amartinezacosta/cSTER-Robotic-Arm-PCB/cSTER_Space_Robotic_Arm_Schematic.html

Partlist exported from C:/Users/Alejandro/Documents/EAGLE/projects/cSTER_Space_Robotic_Arm/cSTER_Space_Robotic_Arm_Schematic.sch at 3/8/2022 9:03 AM

Qty | Value | Device | Package | Parts | Description
1 | | 10-XX | B3F-10XX | S1 | OMRON SWITCH
2 | | C-EUC0603 | C0603 | C37, C40 | CAPACITOR, European symbol
5 | | LEDCHIPLED_0805 | CHIPLED_0805 | LED1, LED2, LED3, LED4, LED5 | LED
1 | | R-US_R0603 | R0603 | R23 | RESISTOR, American symbol
3 | 0.01uF | C-EUC0402K | C0402K | C2, C4, C6 | CAPACITOR, European symbol
2 | 0.01uF | C-EUC0805 | C0805 | C21, C24 | CAPACITOR, European symbol
9 | 0.1uF | C-EUC0402K | C0402K | C1, C3, C5, C9, C10, C28, C30, C38, C39 | CAPACITOR, European symbol
5 | 0.1uF | C-EUC0603 | C0603 | C13, C26, C29, C31, C33 | CAPACITOR, European symbol
4 | 0.2 | R-US_R1206 | R1206 | R3, R4, R5, R6 | RESISTOR, American symbol
1 | 0ZCH0075AF2E | 0ZCH0075AF2E | 0ZCH0075AF2E | F1
1 | 1.0uF | C-EUC0402K | C0402K | C8 | CAPACITOR, European symbol
3 | 100 | R-US_R0603 | R0603 | R20, R21, R22 | RESISTOR, American symbol
1 | 10118194-0001LF | 10118194-0001LF | AMPHENOL_10118194-0001LF | J7 | Micro Usb, 2.0 Type b, Rcpt, Smt
1 | 10K | R-US_R0603 | R0603 | R2 | RESISTOR, American symbol
2 | 10k | R-US_R0402 | R0402 | R7, R10 | RESISTOR, American symbol
8 | 10k | R-US_R0603 | R0603 | R9, R14, R15, R16, R17, R18, R19, R24 | RESISTOR, American symbol
1 | 10nF | C-EUC0603 | C0603 | C27 | CAPACITOR, European symbol
2 | 10pF | C-EUC0402K | C0402K | C14, C15 | CAPACITOR, European symbol
2 | 10uF | C-EUC0603 | C0603 | C19, C32 | CAPACITOR, European symbol
2 | 10uF | C-EUC1206 | C1206 | C17, C18 | CAPACITOR, European symbol
2 | 10uF | CPOL-USCT3216 | CT3216 | C20, C23 | POLARIZED CAPACITOR, American symbol
2 | 150 | R-US_R0603 | R0603 | R11, R13 | RESISTOR, American symbol
1 | 1M | R-US_R0402 | R0402 | R1 | RESISTOR, American symbol
1 | 2.2nF | C-EUC0603 | C0603 | C36 | CAPACITOR, European symbol
1 | 2.2uF | C-EUC0402K | C0402K | C7 | CAPACITOR, European symbol
2 | 2.2uF | C-EUC0603 | C0603 | C22, C25 | CAPACITOR, European symbol
3 | 220 | R-US_R0603 | R0603 | R12, R25, R26 | RESISTOR, American symbol
1 | 22k | R-US_R0603 | R0603 | R27 | RESISTOR, American symbol
3 | 22uF | C-EUC1206 | C1206 | C16, C34, C35 | CAPACITOR, European symbol
2 | 24pF | C-EUC0402K | C0402K | C11, C12 | CAPACITOR, European symbol
1 | 3221-10-0300-00 | 3221-10-0300-00 | 3221-10-0300-00 | J1
1 | 65k | R-US_R0603 | R0603 | R8 | RESISTOR, American symbol
4 | B6B-ZR(LF)(SN) | B6B-ZR(LF)(SN) | JST_B6B-ZR(LF)(SN) | J3, J4, J5, J6 | ZR Series 1.5 mm Pitch 6 Position Through Hole Top Entry Shrouded Heade
1 | CDRH104RNP | CDRH104RNP | CDRH104RNP | L1
9 | CPDQC5V0R | CPDQC5V0R | CPDQC5V0R | D1, D2, D3, D4, D5, D6, D7, D8, D9
2 | DRV8833PW | DRV8833PW | SOP65P640X120-16N | U2, U3
1 | ECS-160-9-42-CKM-TR | ECS-160-9-42-CKM-TR | XTAL_ECS-160-9-42-CKM-TR | Y1 | Crystal 4-SMD, No Lead
1 | JS202011CQN | JS202011CQN | JS202011CQN | U$1
1 | MEM2051-00-195-00-A | MEM2051-00-195-00-A | GCT_MEM2051-00-195-00-A | J9 | Connector, Memory Card, Micro Sd, 8 Position, 1.1mm, Full Reel
1 | MF-MSMF050-2 | MF-MSMF050-2 | FUSM4632X85 | F2 | PTC Resettable Fuse 0.5A(hold) 1A(trip) 15V 100A 0.8W 0.15s 0.15Ohm SMD Solder Pad 1812 T/R
1 | PC-104-PLUS | PC-104-PLUS | PC-104-PLUS | J2
1 | ROBOT_PORT | ROBOT_PORT | ROBOT_PORT | J8
1 | RT3215-32.768-12.5-TR | RT3215-32.768-12.5-TR | RT3215-32.768-12.5-TR | Y2
1 | RT8293B | RT8293B | RT8293B | U12
1 | TM4C1233H6PMIR | TM4C1233H6PMIR | PM0064A_N | U1
21 | TPPAD1-13 | TPPAD1-13 | P1-13 | TP1, TP2, TP3, TP4, TP5, TP7, TP8, TP9, TP10, TP11, TP12, TP13, TP14, TP15, TP16, TP17, TP18, TP19, TP20, TP21, TP22 | Test pad
1 | TPS73633DBVR | TPS73633DBVR | SOT95P280X145-5N | U4 | 400-mA, high-accuracy, ultra-low-dropout voltage regulator with reverse current protection and enable 5-SOT-23 -40 to 125
2 | TXB0102DCURG4 | TXB0102DCURG4 | SOP50P310X90-8N | U5, U6 | 2-Bit Bidirectional Voltage-Level Shifter with Auto Direction Sensing and +/-15-kV ESD Protect 8-VSSOP -40 to 85
