amartinezacosta/cSTER-Robotic-Arm-PCB/cSTER_Space_Robotic_Arm_bottom.png

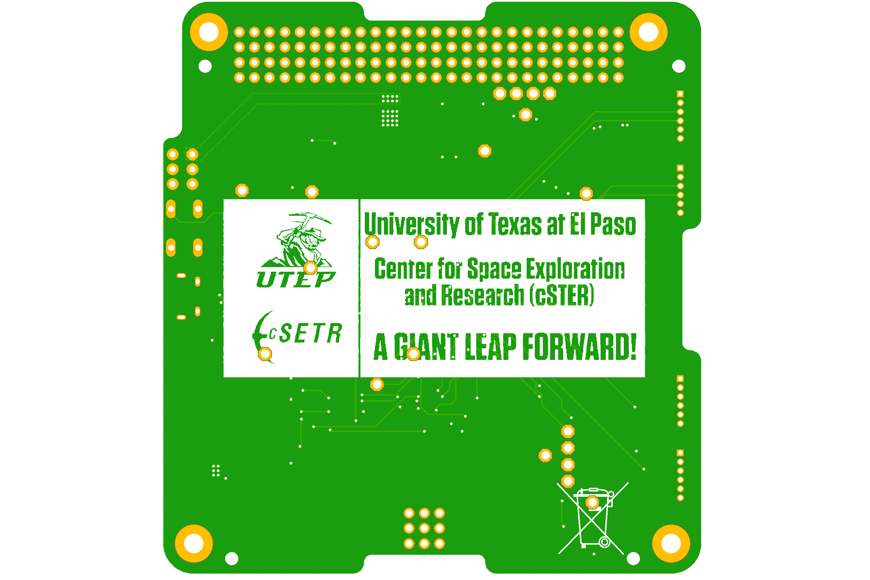
cSTER_Space_Robotic_Arm_bottom.png
