amartinezacosta/cSTER-Robotic-Arm-PCB/cSTER_Space_Robotic_Arm_Schematic.png

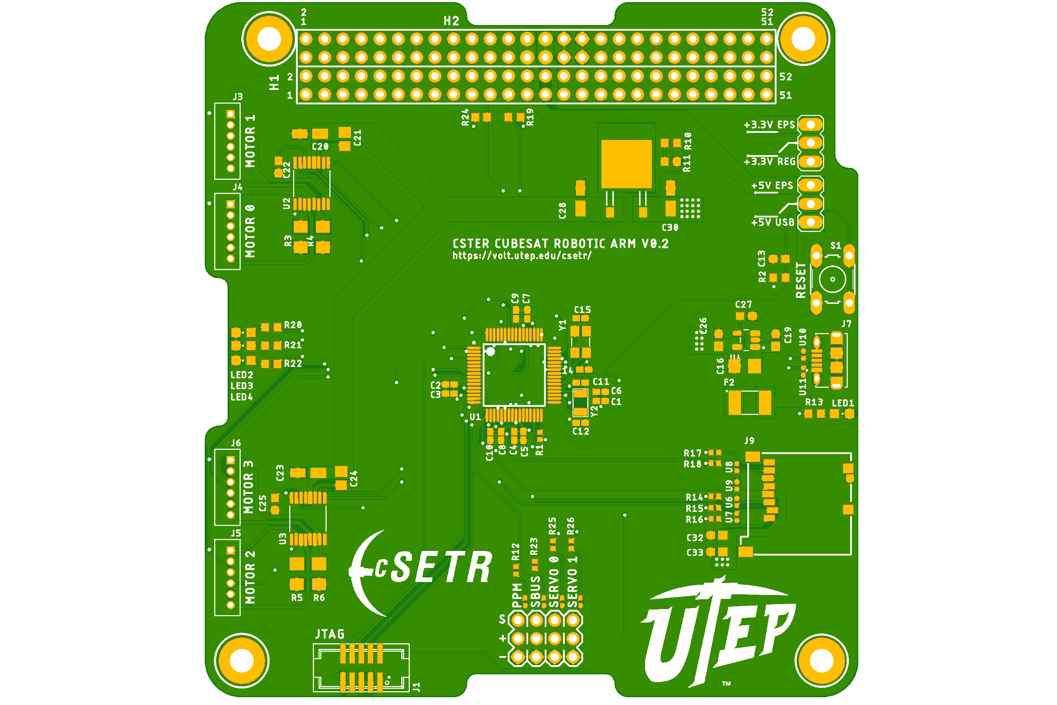
cSTER_Space_Robotic_Arm_Schematic.png
