amartinezacosta/cSTER-Robotic-Arm-PCB/cSTER_Space_Robotic_Arm_Schematic.brd

## EAGLE design cSTER_Space_Robotic_Arm_Schematic.brd (2022-08-25)

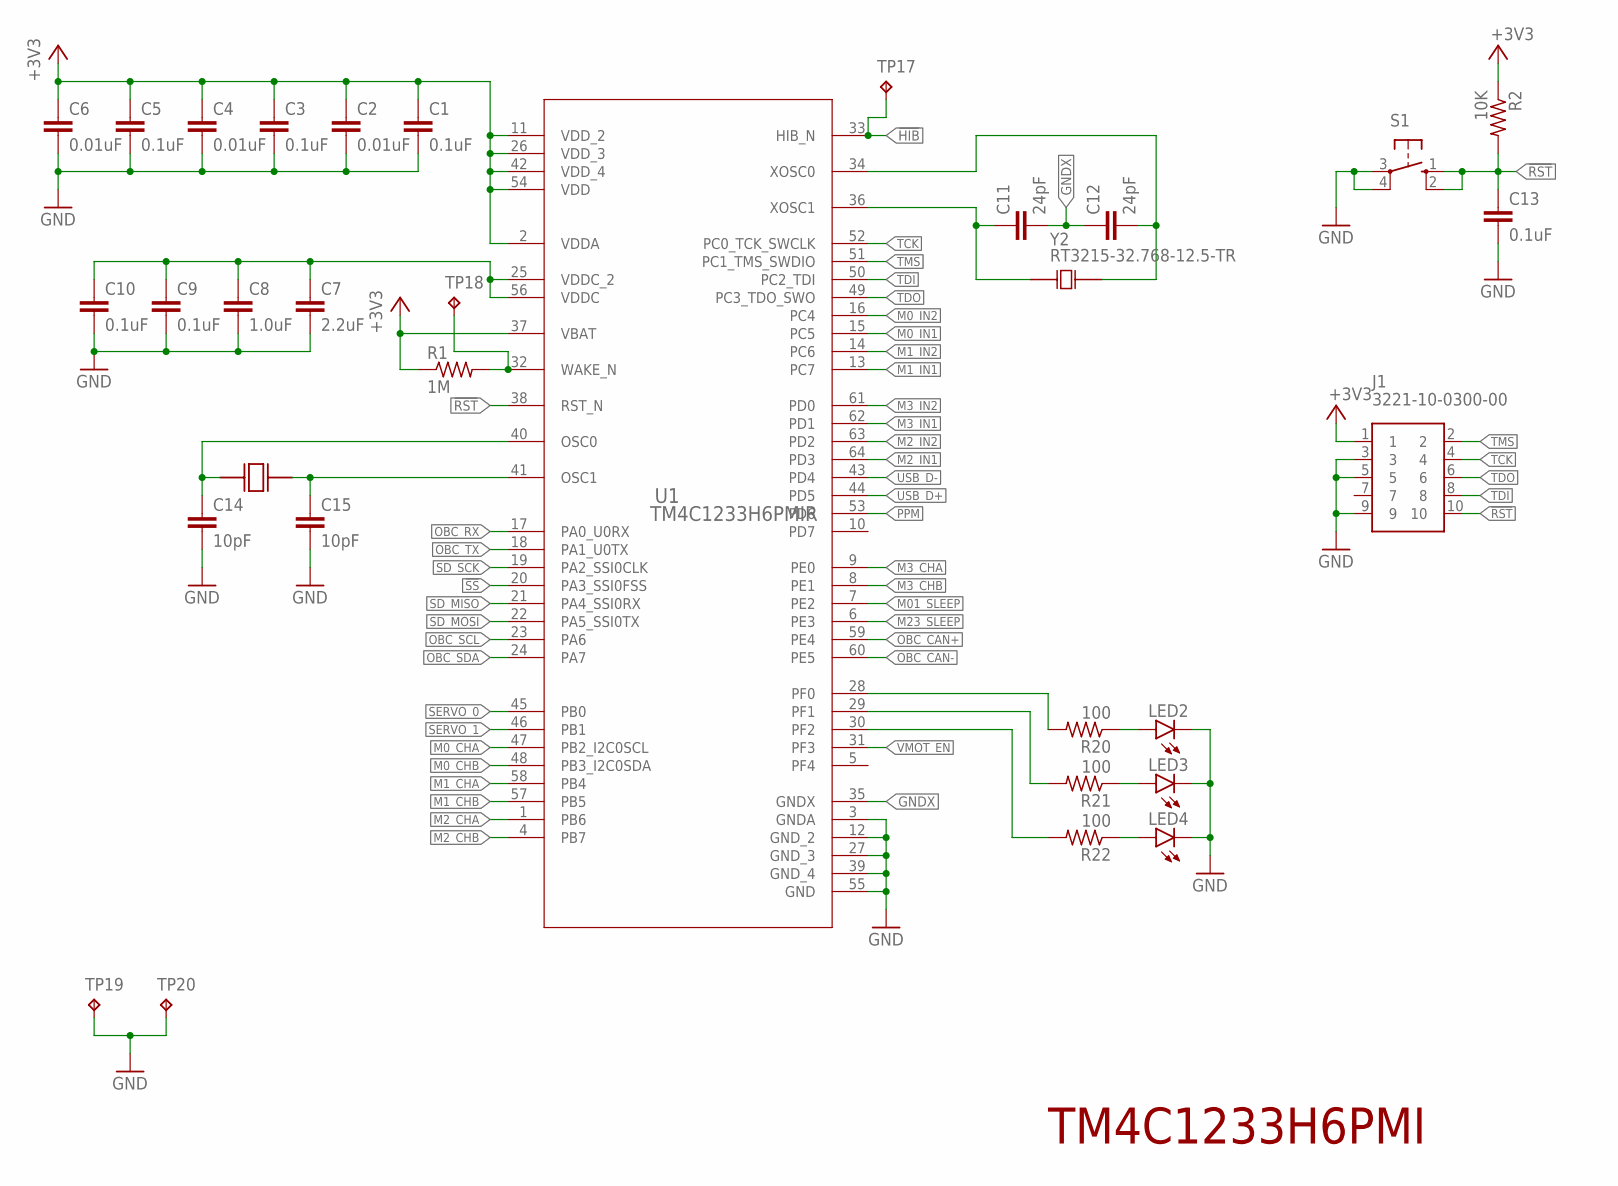
[picture p10: schematic cSTER_Space_Robotic_Arm_Schematic.sch, sheet 1]

Parts:
C1, C3, C5, C9, C10: 0.1uF; C0402K
C2, C4, C6: 0.01uF; C0402K
C7: 2.2uF; C0402K
C8: 1.0uF; C0402K
C11, C12: 24pF; C0402K
C13: 0.1uF; C0603
C14, C15: 10pF; C0402K
J1: 3221-10-0300-00
LED2, LED3, LED4: LEDCHIPLED_0805; CHIPLED_0805
R1: 1M; R0402
R2: 10K; R0603
R20, R21, R22: 100; R0603
S1: 10-XX; B3F-10XX
TP17, TP18, TP19, TP20: TPPAD1-13; P1-13
U1: TM4C1233H6PMIR; PM0064A_N
Y1: ECS-160-9-42-CKM-TR; XTAL_ECS-160-9-42-CKM-TR
Y2: RT3215-32.768-12.5-TR

Connections:
!HIB: TP17.TP, U1.33 (HIB_N)
!RST: C13.1, J1.10, R2.2, S1.1 (S), S1.2 (S1), U1.38 (RST_N)
!SS: U1.20 (PA3_SSI0FSS); also elsewhere on the board
+3V3: C1.1, C2.1, C3.1, C4.1, C5.1, C6.1, J1.1, R1.1, R2.1, U1.2 (VDDA), U1.11 (VDD_2), U1.26 (VDD_3), U1.37 (VBAT), U1.42 (VDD_4), U1.54 (VDD); also elsewhere on the board
GND: C1.2, C2.2, C3.2, C4.2, C5.2, C6.2, C7.2, C8.2, C9.2, C10.2, C13.2, C14.2, C15.2, J1.3, J1.5, J1.9, LED2.C, LED3.C, LED4.C, S1.3, S1.4 (P1), TP19.TP, TP20.TP, U1.3 (GNDA), U1.12 (GND_2), U1.27 (GND_3), U1.39 (GND_4), U1.55 (GND); also elsewhere on the board
GNDX: C11.2, C12.1, U1.35 (GNDX)
M0_CHA: U1.47 (PB2_I2C0SCL); also elsewhere on the board
M0_CHB: U1.48 (PB3_I2C0SDA); also elsewhere on the board
M0_IN1: U1.15 (PC5); also elsewhere on the board
M0_IN2: U1.16 (PC4); also elsewhere on the board
M1_CHA: U1.58 (PB4); also elsewhere on the board
M1_CHB: U1.57 (PB5); also elsewhere on the board
M1_IN1: U1.13 (PC7); also elsewhere on the board
M1_IN2: U1.14 (PC6); also elsewhere on the board
M01_SLEEP: U1.7 (PE2); also elsewhere on the board
M2_CHA: U1.1 (PB6); also elsewhere on the board
M2_CHB: U1.4 (PB7); also elsewhere on the board
M2_IN1: U1.64 (PD3); also elsewhere on the board
M2_IN2: U1.63 (PD2); also elsewhere on the board
M3_CHA: U1.9 (PE0); also elsewhere on the board
M3_CHB: U1.8 (PE1); also elsewhere on the board
M3_IN1: U1.62 (PD1); also elsewhere on the board
M3_IN2: U1.61 (PD0); also elsewhere on the board
M23_SLEEP: U1.6 (PE3); also elsewhere on the board
unnamed: C11.1, U1.36 (XOSC1), Y2.1
unnamed: C14.1, U1.40 (OSC0), Y1.1
unnamed: C12.2, U1.34 (XOSC0), Y2.2
unnamed: R1.2, TP18.TP, U1.32 (WAKE_N)
unnamed: C7.1, C8.1, C9.1, C10.1, U1.25 (VDDC_2), U1.56 (VDDC)
unnamed: C15.1, U1.41 (OSC1), Y1.3 (2)
unnamed: LED2.A, R20.1
unnamed: LED3.A, R21.1
unnamed: LED4.A, R22.1
unnamed: R20.2, U1.28 (PF0)
unnamed: R21.2, U1.29 (PF1)
unnamed: R22.2, U1.30 (PF2)
OBC_CAN+: U1.59 (PE4); also elsewhere on the board
OBC_CAN-: U1.60 (PE5); also elsewhere on the board
OBC_RX: U1.17 (PA0_U0RX); also elsewhere on the board
OBC_SCL: U1.23 (PA6); also elsewhere on the board
OBC_SDA: U1.24 (PA7); also elsewhere on the board
OBC_TX: U1.18 (PA1_U0TX); also elsewhere on the board
PPM: U1.53 (PD6); also elsewhere on the board
SD_MISO: U1.21 (PA4_SSI0RX); also elsewhere on the board
SD_MOSI: U1.22 (PA5_SSI0TX); also elsewhere on the board
SD_SCK: U1.19 (PA2_SSI0CLK); also elsewhere on the board
SERVO_0: U1.45 (PB0); also elsewhere on the board
SERVO_1: U1.46 (PB1); also elsewhere on the board
TCK: J1.4, U1.52 (PC0_TCK_SWCLK)
TDI: J1.8, U1.50 (PC2_TDI)
TDO: J1.6, U1.49 (PC3_TDO_SWO)
TMS: J1.2, U1.51 (PC1_TMS_SWDIO)
USB_D+: U1.44 (PD5); also elsewhere on the board
USB_D-: U1.43 (PD4); also elsewhere on the board
VMOT_EN: U1.31 (PF3); also elsewhere on the board

Notes on the sheet:
TM4C1233H6PMI

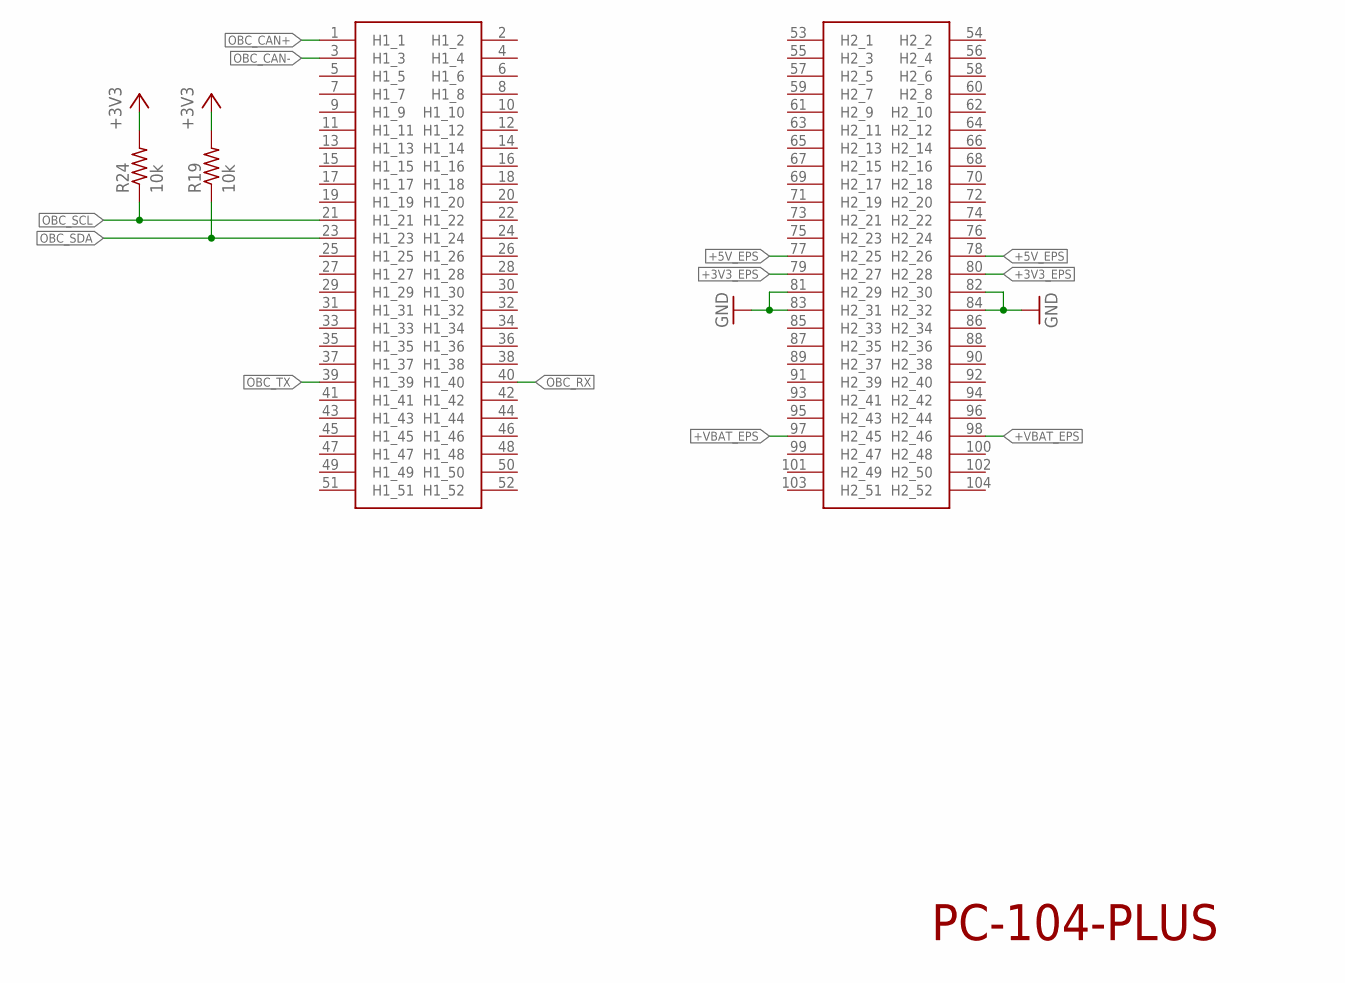
[picture p11: schematic cSTER_Space_Robotic_Arm_Schematic.sch, sheet 2]

Parts:
J2: PC-104-PLUS
R19, R24: 10k; R0603

Connections:
+3V3: R19.2, R24.2; also elsewhere on the board
+3V3_EPS: J2.79 (H2_27), J2.80 (H2_28); also elsewhere on the board
+5V_EPS: J2.77 (H2_25), J2.78 (H2_26); also elsewhere on the board
+VBAT_EPS: J2.97 (H2_45), J2.98 (H2_46); also elsewhere on the board
GND: J2.81 (H2_29), J2.82 (H2_30), J2.83 (H2_31), J2.84 (H2_32); also elsewhere on the board
OBC_CAN+: J2.1 (H1_1); also elsewhere on the board
OBC_CAN-: J2.3 (H1_3); also elsewhere on the board
OBC_RX: J2.40 (H1_40); also elsewhere on the board
OBC_SCL: J2.21 (H1_21), R24.1; also elsewhere on the board
OBC_SDA: J2.23 (H1_23), R19.1; also elsewhere on the board
OBC_TX: J2.39 (H1_39); also elsewhere on the board

Notes on the sheet:
PC-104-PLUS

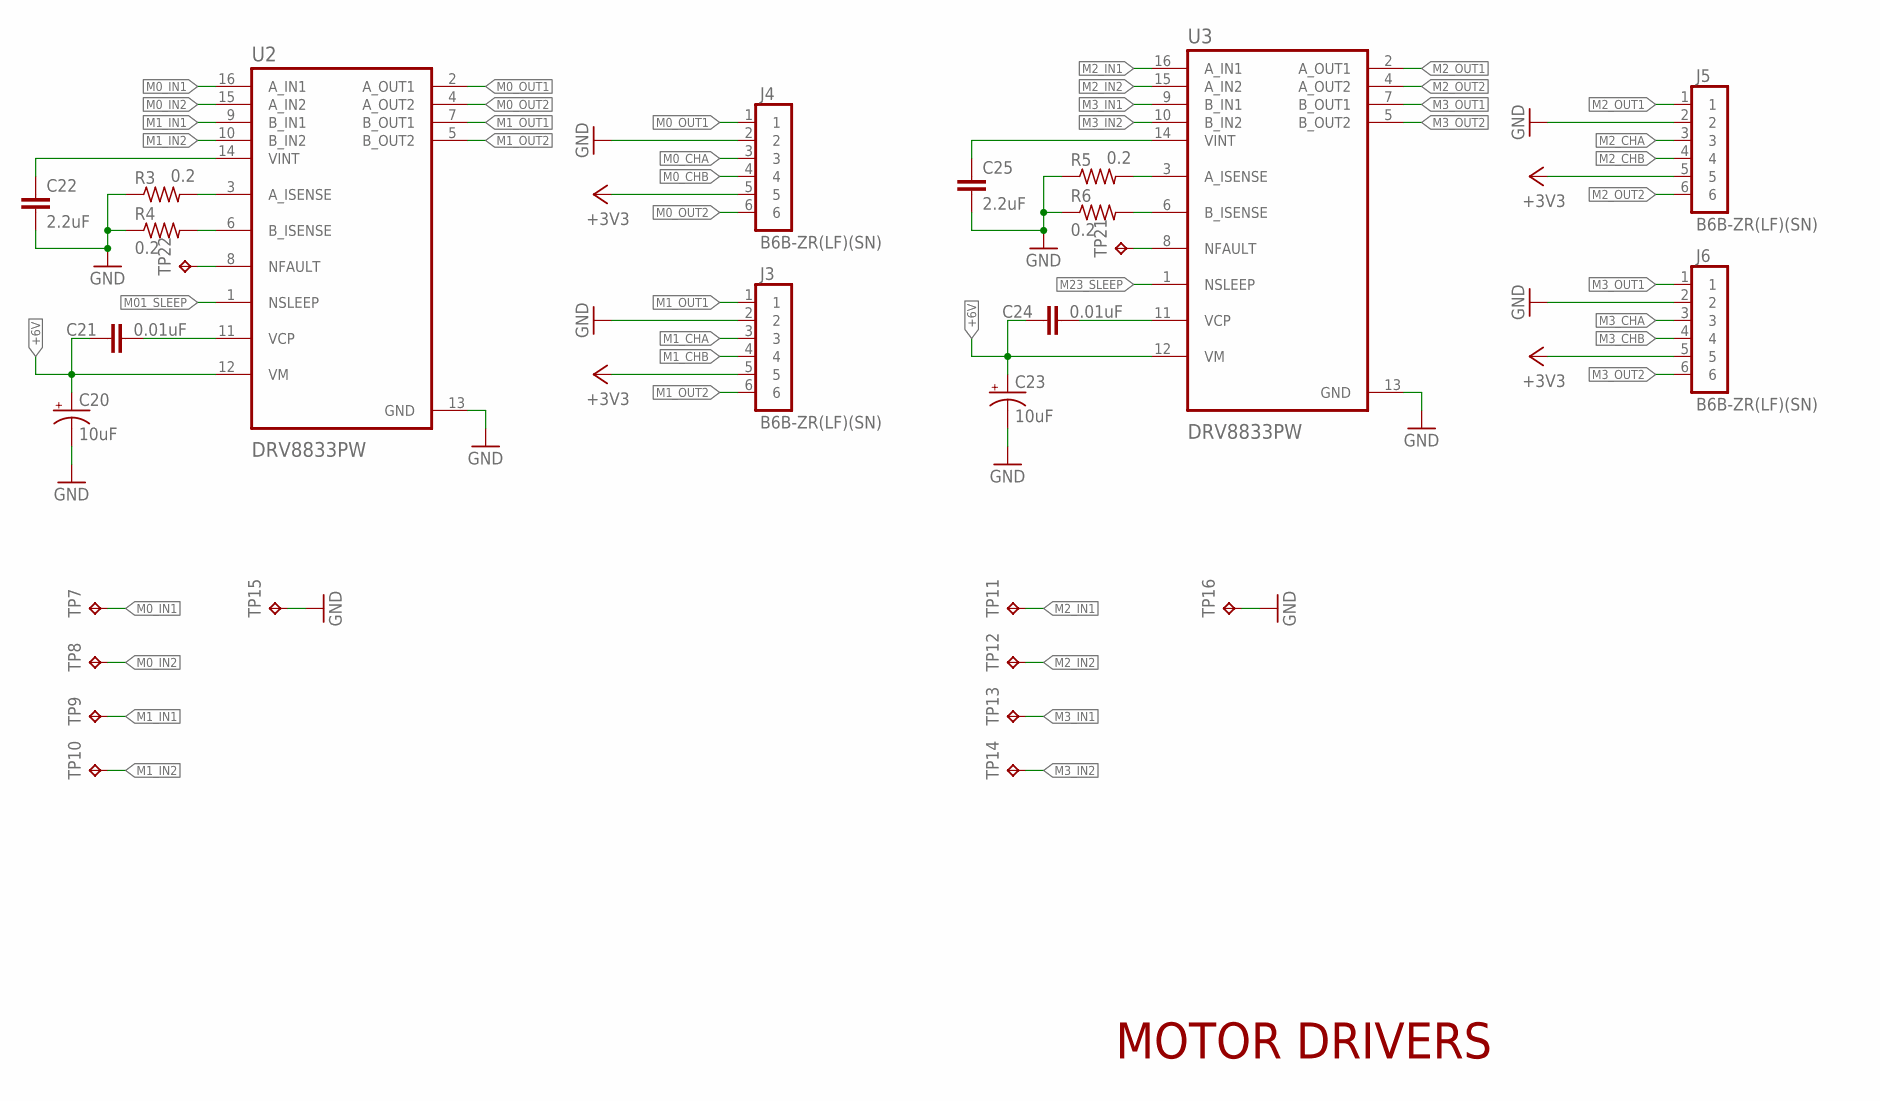
[picture p12: schematic cSTER_Space_Robotic_Arm_Schematic.sch, sheet 3]

Parts:
C20, C23: 10uF; CT3216
C21, C24: 0.01uF; C0805
C22, C25: 2.2uF; C0603
J3, J4, J5, J6: B6B-ZR(LF)(SN); JST_B6B-ZR(LF)(SN)
R3, R4, R5, R6: 0.2; R1206
TP7, TP8, TP9, TP10, TP11, TP12, TP13, TP14, TP15, TP16, TP21, TP22: TPPAD1-13; P1-13
U2, U3: DRV8833PW; SOP65P640X120-16N

Connections:
+3V3: J3.5, J4.5, J5.5, J6.5; also elsewhere on the board
+6V: C20.+, C21.1, C23.+, C24.1, U2.12 (VM), U3.12 (VM); also elsewhere on the board
GND: C20.-, C22.2, C23.-, C25.2, J3.2, J4.2, J5.2, J6.2, R3.1, R4.1, R5.1, R6.1, TP15.TP, TP16.TP, U2.13 (GND), U3.13 (GND); also elsewhere on the board
M0_CHA: J4.3; also elsewhere on the board
M0_CHB: J4.4; also elsewhere on the board
M0_IN1: TP7.TP, U2.16 (A_IN1); also elsewhere on the board
M0_IN2: TP8.TP, U2.15 (A_IN2); also elsewhere on the board
M0_OUT1: J4.1, U2.2 (A_OUT1)
M0_OUT2: J4.6, U2.4 (A_OUT2)
M1_CHA: J3.3; also elsewhere on the board
M1_CHB: J3.4; also elsewhere on the board
M1_IN1: TP9.TP, U2.9 (B_IN1); also elsewhere on the board
M1_IN2: TP10.TP, U2.10 (B_IN2); also elsewhere on the board
M1_OUT1: J3.1, U2.7 (B_OUT1)
M1_OUT2: J3.6, U2.5 (B_OUT2)
M01_SLEEP: U2.1 (NSLEEP); also elsewhere on the board
M2_CHA: J5.3; also elsewhere on the board
M2_CHB: J5.4; also elsewhere on the board
M2_IN1: TP11.TP, U3.16 (A_IN1); also elsewhere on the board
M2_IN2: TP12.TP, U3.15 (A_IN2); also elsewhere on the board
M2_OUT1: J5.1, U3.2 (A_OUT1)
M2_OUT2: J5.6, U3.4 (A_OUT2)
M3_CHA: J6.3; also elsewhere on the board
M3_CHB: J6.4; also elsewhere on the board
M3_IN1: TP13.TP, U3.9 (B_IN1); also elsewhere on the board
M3_IN2: TP14.TP, U3.10 (B_IN2); also elsewhere on the board
M3_OUT1: J6.1, U3.7 (B_OUT1)
M3_OUT2: J6.6, U3.5 (B_OUT2)
M23_SLEEP: U3.1 (NSLEEP); also elsewhere on the board
unnamed: R3.2, U2.3 (A_ISENSE)
unnamed: R4.2, U2.6 (B_ISENSE)
unnamed: C21.2, U2.11 (VCP)
unnamed: C22.1, U2.14 (VINT)
unnamed: R5.2, U3.3 (A_ISENSE)
unnamed: R6.2, U3.6 (B_ISENSE)
unnamed: C24.2, U3.11 (VCP)
unnamed: TP21.TP, U3.8 (NFAULT)
unnamed: C25.1, U3.14 (VINT)
unnamed: TP22.TP, U2.8 (NFAULT)

Notes on the sheet:
MOTOR DRIVERS

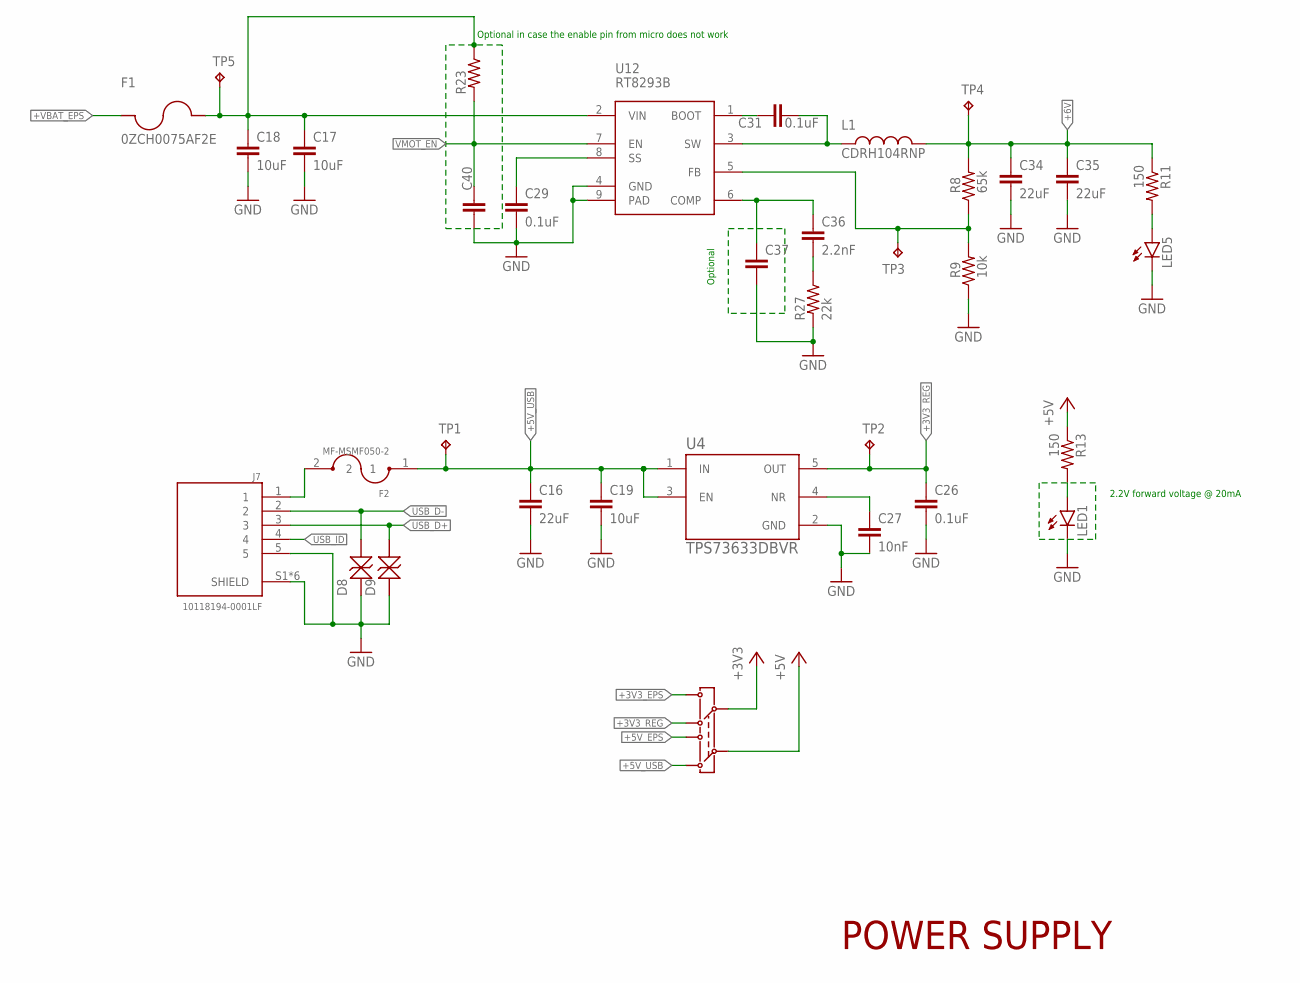
[picture p13: schematic cSTER_Space_Robotic_Arm_Schematic.sch, sheet 4]

Parts:
C16, C34, C35: 22uF; C1206
C17, C18: 10uF; C1206
C19: 10uF; C0603
C26, C29, C31: 0.1uF; C0603
C27: 10nF; C0603
C36: 2.2nF; C0603
C37, C40: C-EUC0603; C0603
D8, D9: CPDQC5V0R
F1: 0ZCH0075AF2E
F2: MF-MSMF050-2; FUSM4632X85
J7: 10118194-0001LF; AMPHENOL_10118194-0001LF
L1: CDRH104RNP
LED1, LED5: LEDCHIPLED_0805; CHIPLED_0805
R8: 65k; R0603
R9: 10k; R0603
R11, R13: 150; R0603
R23: R-US_R0603; R0603
R27: 22k; R0603
TP1, TP2, TP3, TP4, TP5: TPPAD1-13; P1-13
U4: TPS73633DBVR; SOT95P280X145-5N
U12: RT8293B
U$1: JS202011CQN

Connections:
+3V3: U$1.5; also elsewhere on the board
+3V3_EPS: U$1.6; also elsewhere on the board
+3V3_REG: C26.1, TP2.TP, U4.5 (OUT), U$1.4
+5V: R13.1, U$1.2; also elsewhere on the board
+5V_EPS: U$1.3; also elsewhere on the board
+5V_USB: C16.1, C19.1, F2.1, TP1.TP, U4.1 (IN), U4.3 (EN), U$1.1
+6V: C34.1, C35.1, L1.2, R8.2, R11.1, TP4.TP; also elsewhere on the board
+VBAT_EPS: F1.1; also elsewhere on the board
GND: C16.2, C17.2, C18.2, C19.2, C26.2, C27.2, C29.2, C34.2, C35.2, C37.2, C40.1, D8.1, D9.1, J7.5, J7.S1 (SHIELD), J7.S2 (SHIELD), J7.S3 (SHIELD), J7.S4 (SHIELD), J7.S5 (SHIELD), J7.S6 (SHIELD), LED1.C, LED5.C, R9.1, R27.2, U4.2 (GND), U12.4 (GND), U12.9 (PAD); also elsewhere on the board
unnamed: F2.2, J7.1
unnamed: C31.1, U12.1 (BOOT)
unnamed: C27.1, U4.4 (NR)
unnamed: C29.1, U12.8 (SS)
unnamed: LED1.A, R13.2
unnamed: LED5.A, R11.2
unnamed: C31.2, L1.1, U12.3 (SW)
unnamed: R8.1, R9.2, TP3.TP, U12.5 (FB)
unnamed: C36.1, C37.1, U12.6 (COMP)
unnamed: C36.2, R27.1
unnamed: C17.1, C18.1, F1.2, R23.1, TP5.TP, U12.2 (VIN)
USB_D+: D9.2, J7.3; also elsewhere on the board
USB_D-: D8.2, J7.2; also elsewhere on the board
USB_ID: J7.4
VMOT_EN: C40.2, R23.2, U12.7 (EN); also elsewhere on the board

Notes on the sheet:
POWER SUPPLY
2.2V forward voltage @ 20mA
Optional
Optional in case the enable pin from micro does not work

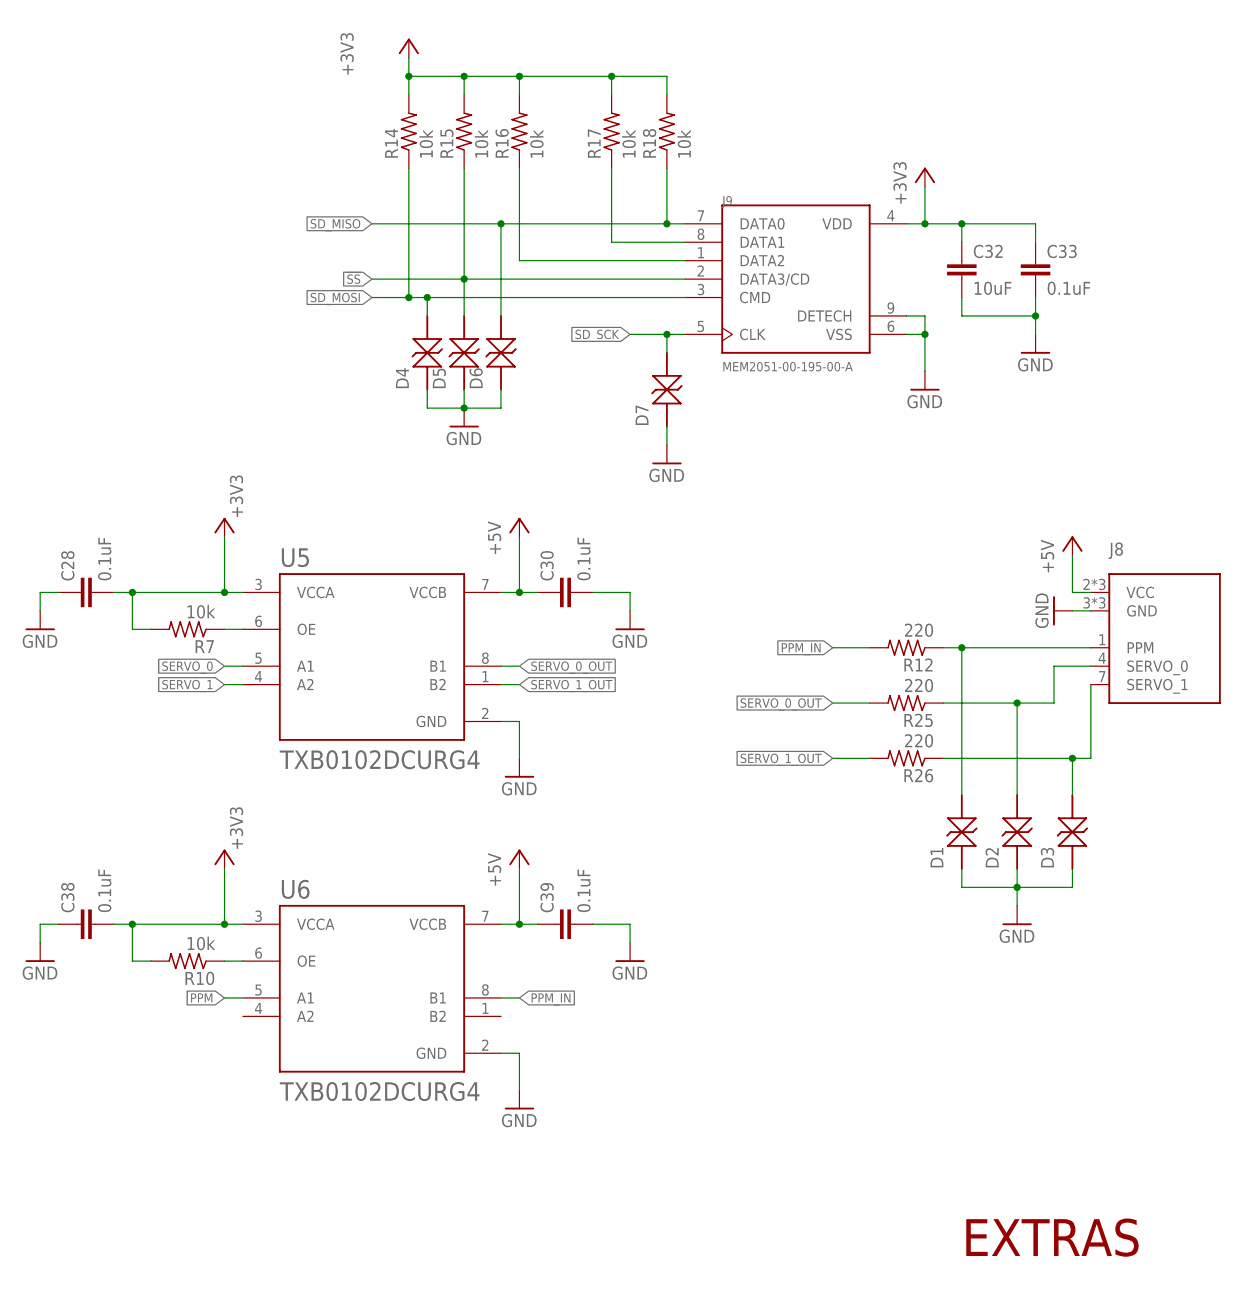
[picture p14: schematic cSTER_Space_Robotic_Arm_Schematic.sch, sheet 5]

Parts:
C28, C30, C38, C39: 0.1uF; C0402K
C32: 10uF; C0603
C33: 0.1uF; C0603
D1, D2, D3, D4, D5, D6, D7: CPDQC5V0R
J8: ROBOT_PORT
J9: MEM2051-00-195-00-A; GCT_MEM2051-00-195-00-A
R7, R10: 10k; R0402
R12, R25, R26: 220; R0603
R14, R15, R16, R17, R18: 10k; R0603
U5, U6: TXB0102DCURG4; SOP50P310X90-8N

Connections:
!SS: D5.2, J9.2 (DATA3/CD), R15.1; also elsewhere on the board
+3V3: C28.2, C32.1, C33.1, C38.2, J9.4 (VDD), R7.2, R10.2, R14.2, R15.2, R16.2, R17.2, R18.2, U5.3 (VCCA), U6.3 (VCCA); also elsewhere on the board
+5V: C30.1, C39.1, J8.2 (VCC), J8.5 (VCC), J8.8 (VCC), U5.7 (VCCB), U6.7 (VCCB); also elsewhere on the board
GND: C28.1, C30.2, C32.2, C33.2, C38.1, C39.2, D1.1, D2.1, D3.1, D4.1, D5.1, D6.1, D7.1, J8.3 (GND), J8.6 (GND), J8.9 (GND), J9.6 (VSS), J9.9 (DETECH), U5.2 (GND), U6.2 (GND); also elsewhere on the board
unnamed: R7.1, U5.6 (OE)
unnamed: D3.2, J8.7 (SERVO_1), R26.1
unnamed: J9.8 (DATA1), R17.1
unnamed: J9.1 (DATA2), R16.1
unnamed: D2.2, J8.4 (SERVO_0), R25.1
unnamed: R10.1, U6.6 (OE)
unnamed: D1.2, J8.1 (PPM), R12.1
PPM: U6.5 (A1); also elsewhere on the board
PPM_IN: R12.2, U6.8 (B1)
SD_MISO: D6.2, J9.7 (DATA0), R18.1; also elsewhere on the board
SD_MOSI: D4.2, J9.3 (CMD), R14.1; also elsewhere on the board
SD_SCK: D7.2, J9.5 (CLK); also elsewhere on the board
SERVO_0: U5.5 (A1); also elsewhere on the board
SERVO_0_OUT: R25.2, U5.8 (B1)
SERVO_1: U5.4 (A2); also elsewhere on the board
SERVO_1_OUT: R26.2, U5.1 (B2)

Notes on the sheet:
EXTRAS

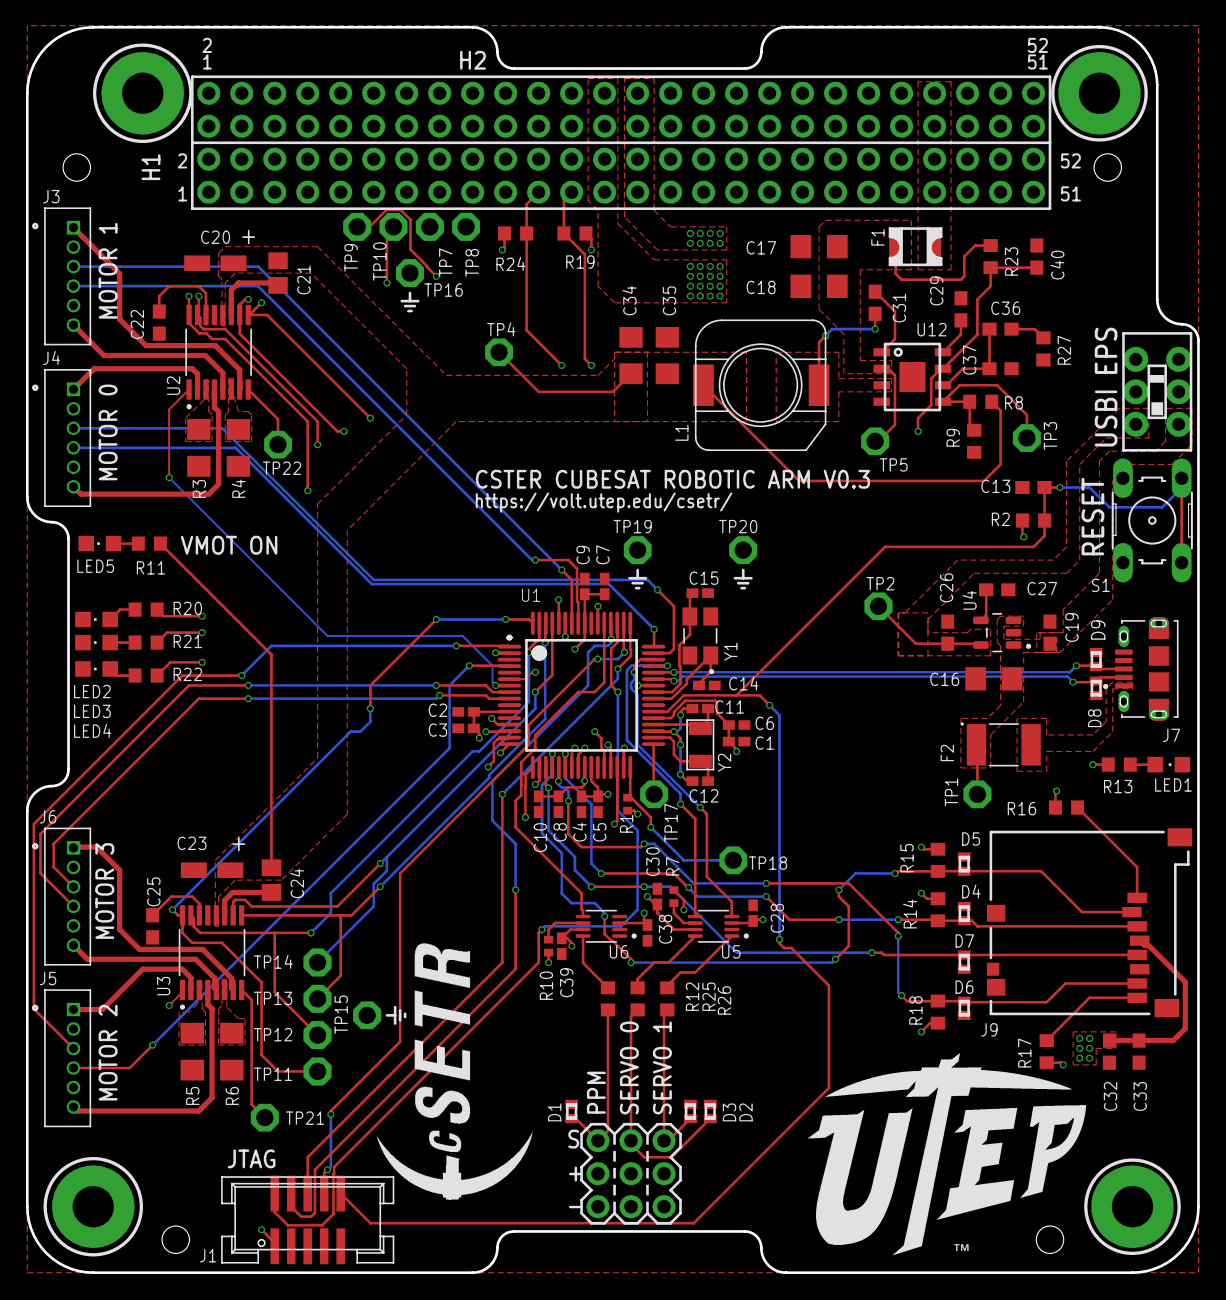
[picture p15: board cSTER_Space_Robotic_Arm_Schematic.brd from above]

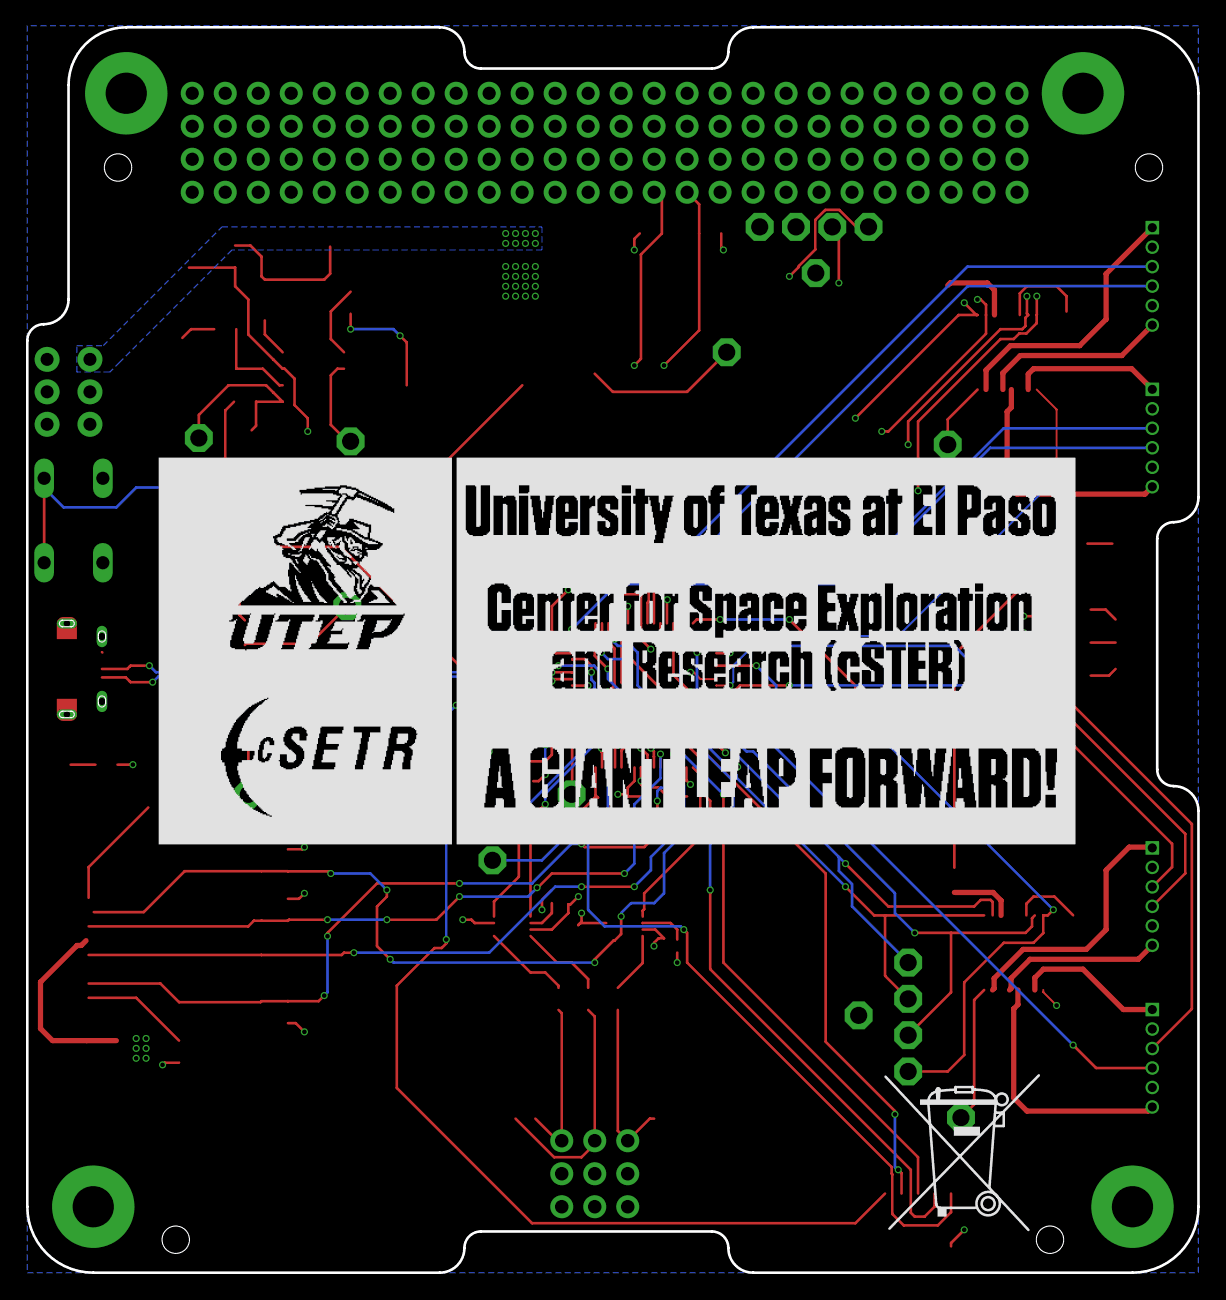
[picture p16: board cSTER_Space_Robotic_Arm_Schematic.brd from below]

Board: 4 copper layers, 90.2 x 95.9 mm, 133 parts (2 on the bottom side), 101 nets.

Other parts of the board:
U$4: CSTER
U$5: UTEP_LOGO
U$7: CSTER_UTEP_LOGO
U$8: MUELLTONNE
U$10, U$11, U$13, U$14: GND
